shivam4567412/sic-mosfet-gate-driver/docs/internshipreport.pdf

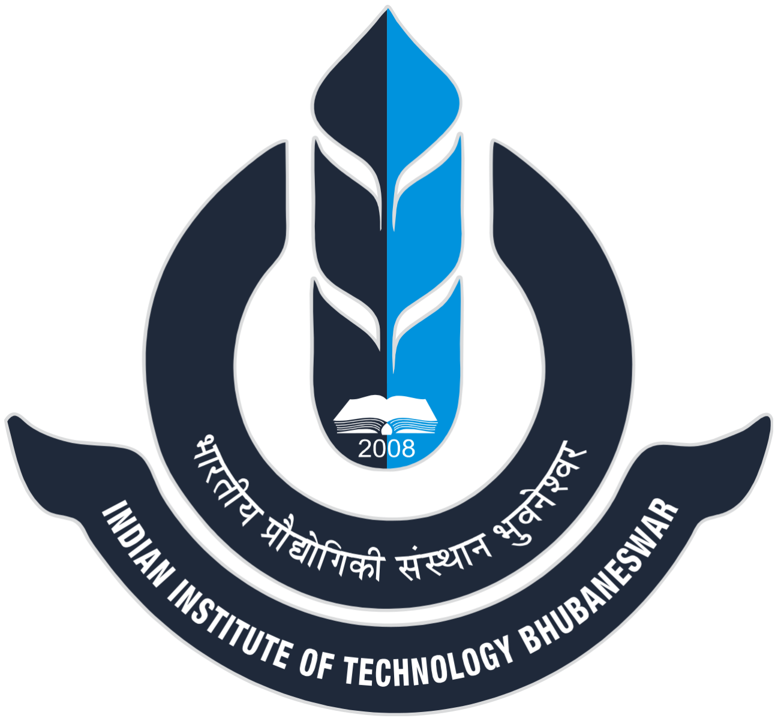
[picture p1: figure]

## Department Of Electrical Engineering

# Summer Internship Report

Name of Intern – Shivam Maurya

Institute – IIT Bhilai

Mentor – Dr. Olive Ray

Duration of internship – 4 Weeks (14 May 2026 to 10 June 2026)

## Design, Simulation, and Experimental Characterization of a SiC MOSFET Gate Driver System

## Time Line of Tasks –

- 14 May: Joining
- 14 May – 16 May: Altium Installation and BaSICs
- 16 May – 19 May: Made the schematic of STGAP2SICSNC isolated 4 A single gate driver using the Datasheet.
- 19May- 25May: Learned the PCB baSICs and then Designed a two-layer PCB for the same schematic in Altium. Also, made the BJT part of circuit of Murata power supply for analysis in LT spice. Concluded its working as an emitter follower.
- 25May – 26May: learned about Gerber files and how to export the PCB design for fabrication.
- 26May – 28May: Simulated the Gate driver circuit on LT spice and got the switching node waveform as expected.
- 28May – 31May: Learned about code composer studio and the microcontroller TMS320F28379D’s programming logic.
- 1June – 8June: Made the code for continuous pulse signal with deadband and used it first for checking the gate driver board, then performed the pulse test and captured the switching waveform and calculated the switching loss which were verified from the oscilloscope readings.
- 8June – 10June: Applied complementary signals at both the switches to capture the complementary switching waveform and also developed the code of double pulse.

## Introduction

This report presents the work carried out during a four-week summer internship at the Department of Electrical Engineering, IIT Bhubaneswar, from 14 May 2026 to 10 June 2026, under the guidance of Dr. Olive Ray. The internship focused on the design, simulation, and experimental characterization of power electronics circuits, with a specific emphasis on Silicon Carbide (SiC) MOSFET-based gate driver systems.

Wide Bandgap (WBG) semiconductor devices such as SiC MOSFETs have emerged as a preferred choice in modern power conversion systems owing to their superior switching speed, higher breakdown voltage, and lower conduction losses compared to conventional silicon devices. However, their fast-switching characteristics also introduce challenges such as parasitic ringing and precise gate drive requirements, making their experimental characterization an important area of study.

The internship covered a broad range of practical tasks: schematic design and PCB layout of an isolated gate driver circuit using the STGAP2SICSNC gate driver IC in Altium Designer, circuit simulation in LTspice, embedded firmware development for the TMS320F28379D C2000 microcontroller using Code Composer Studio (CCS), and hardware testing including continuous pulse generation, deadband signal verification, and the Double Pulse Test (DPT) for switching loss characterization of SCT35N65 SIC MOSFETs. Switching energies were measured using the Yokogawa DLM3054 oscilloscope.

This report documents the timeline of tasks, the technical methodology followed, key experimental results, and the challenges encountered along with how they were resolved.

## Brief Summary of Each Task

1 - Altium Designer – Schematic & PCB Basics

During the initial phase, I learned Altium Designer, a professional PCB design software widely used in the industry. I learned how to source and add components from online libraries such as Ultra Librarian and Element14, ensuring the correct symbols and footprints were imported. I also understood the importance of verifying component footprints against actual fabrication constraints to avoid design errors during manufacturing. Additionally, I gained familiarity with various passive and active components used in PCB design, including connectors, headers, test points, jumpers, and other standard circuit elements.

The following figure is from the data sheet of the gate driver

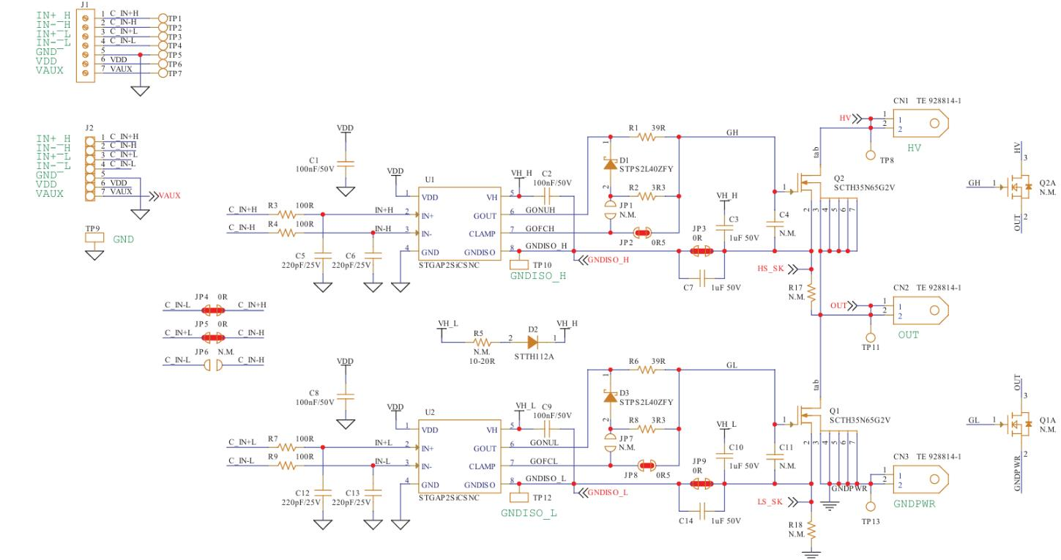
[picture p2: figure]
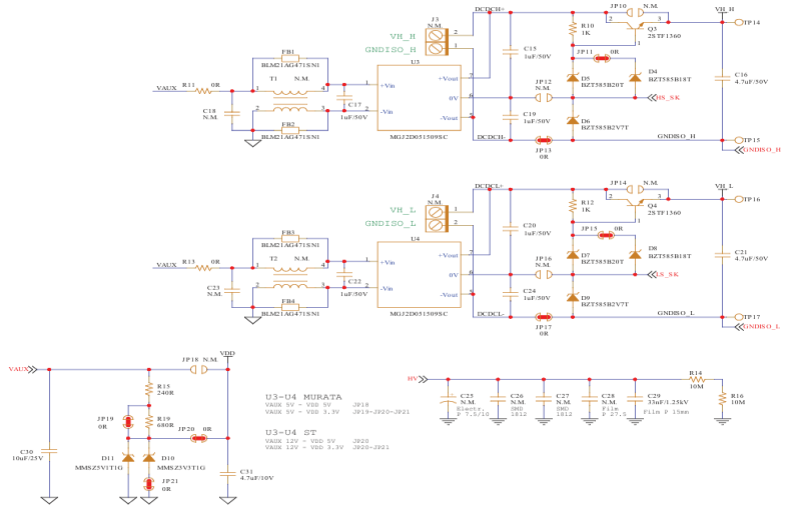
[picture p3: figure]
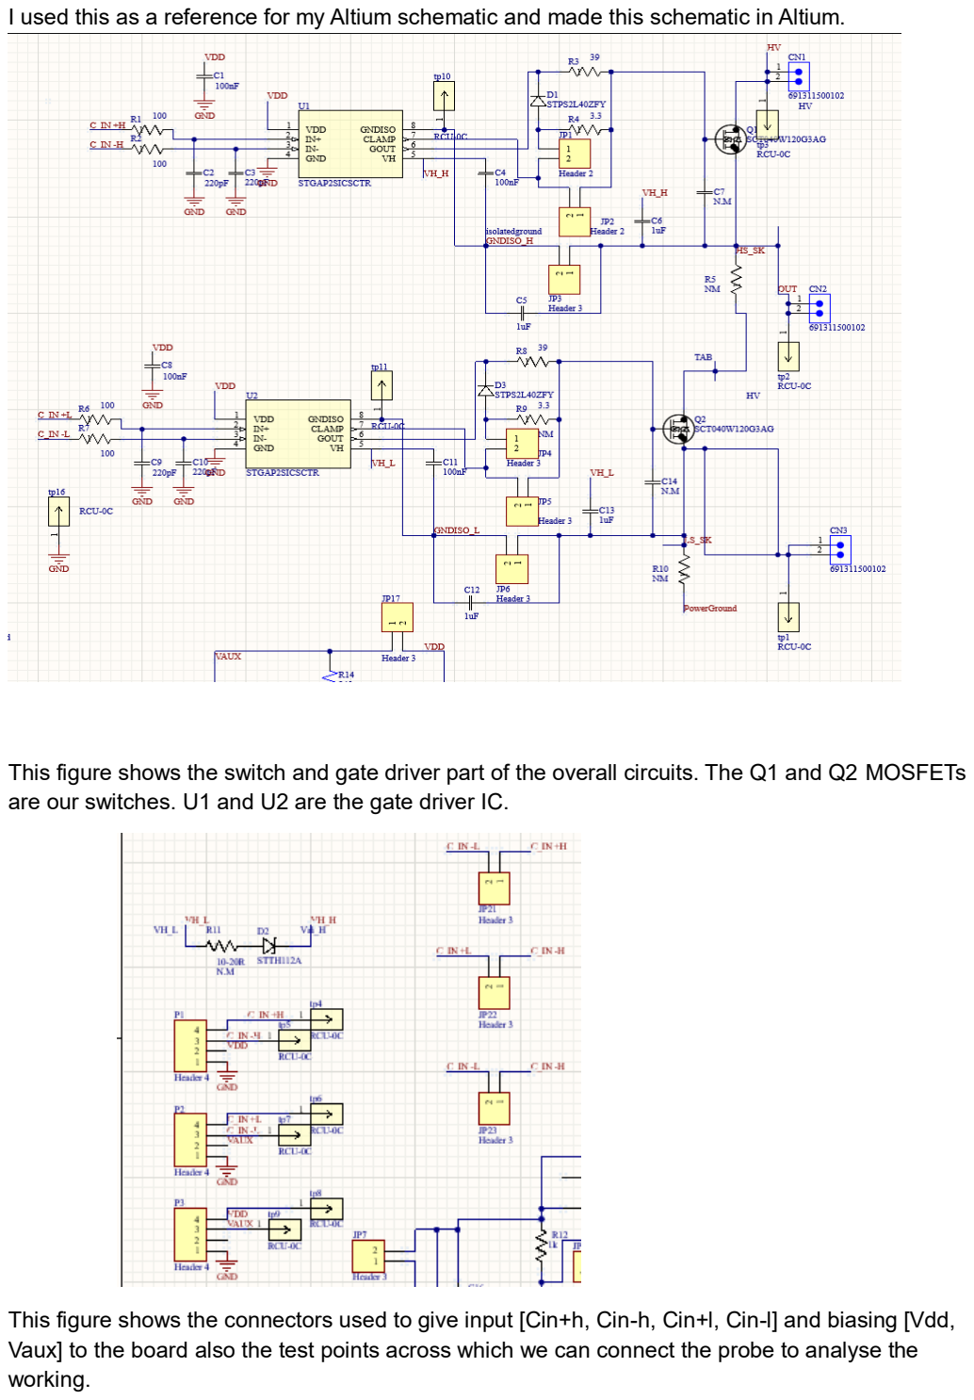
[picture p4: page 5]

I used this as a reference for my Altium schematic and made this schematic in Altium.

This figure shows the switch and gate driver part of the overall circuits. The Q1 and Q2 MOSFETs are our switches. U1 and U2 are the gate driver IC.

This figure shows the connectors used to give input [Cin+h, Cin-h, Cin+l, Cin-l] and biasing [Vdd, Vaux] to the board also the test points across which we can connect the probe to analyse the working.

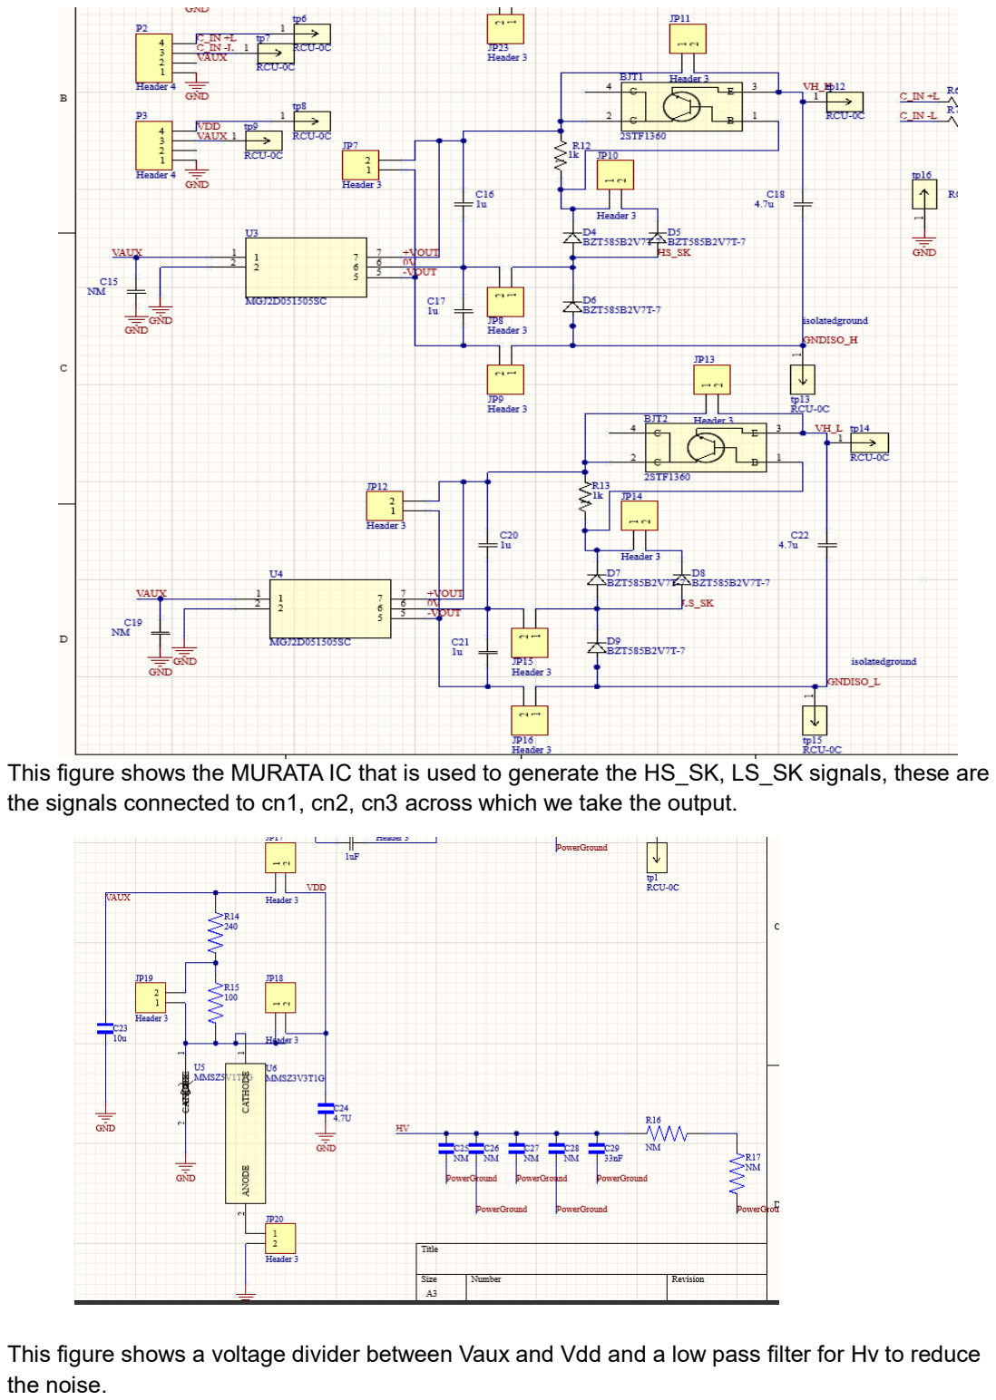
[picture p5: page 6]

This figure shows the MURATA IC that is used to generate the HS_SK, LS_SK signals, these are the signals connected to cn1, cn2, cn3 across which we take the output.

This figure shows a voltage divider between Vaux and Vdd and a low pass filter for Hv to reduce the noise.

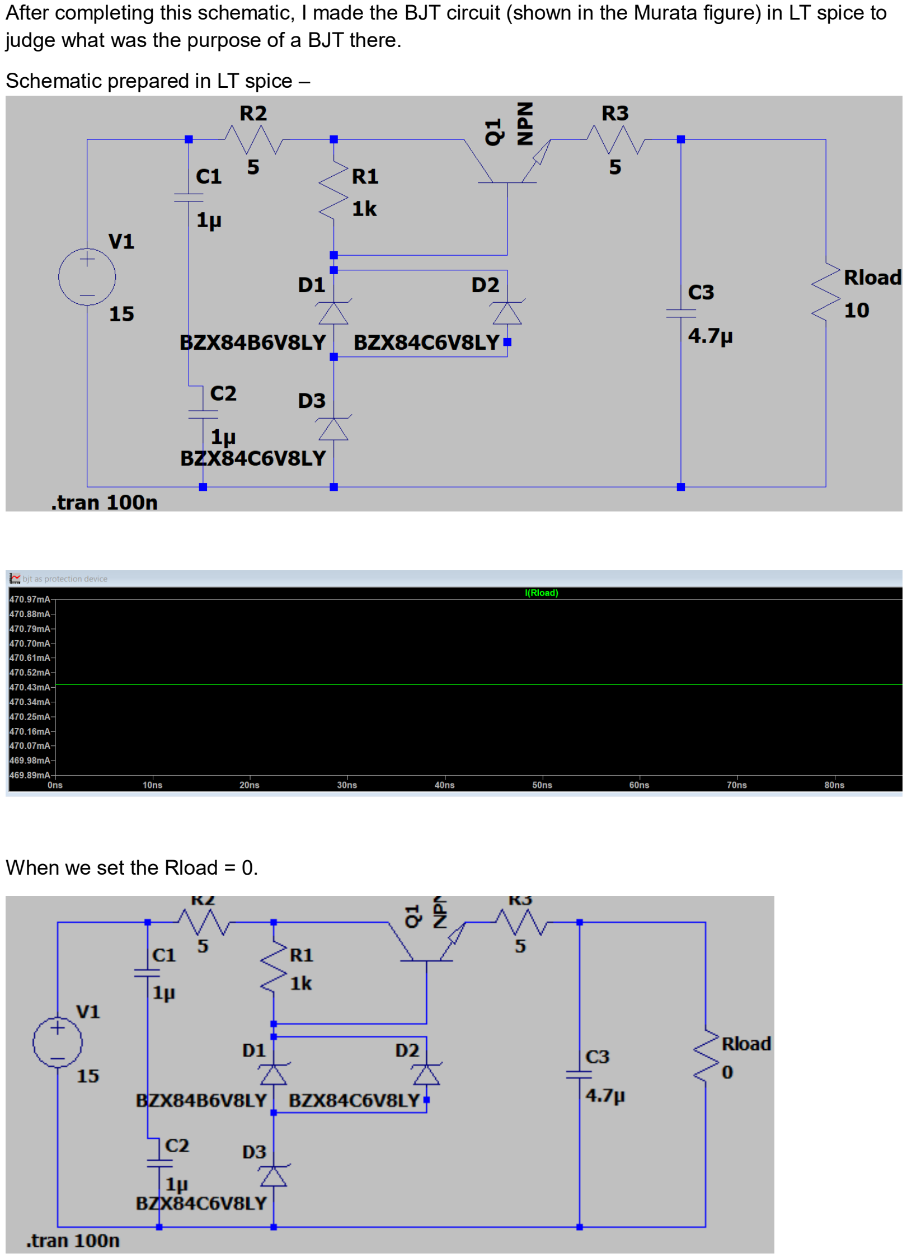
[picture p6: page 7]

After completing this schematic, I made the BJT circuit (shown in the Murata figure) in LT spice to judge what was the purpose of a BJT there.

Schematic prepared in LT spice –

When we set the Rload = 0.

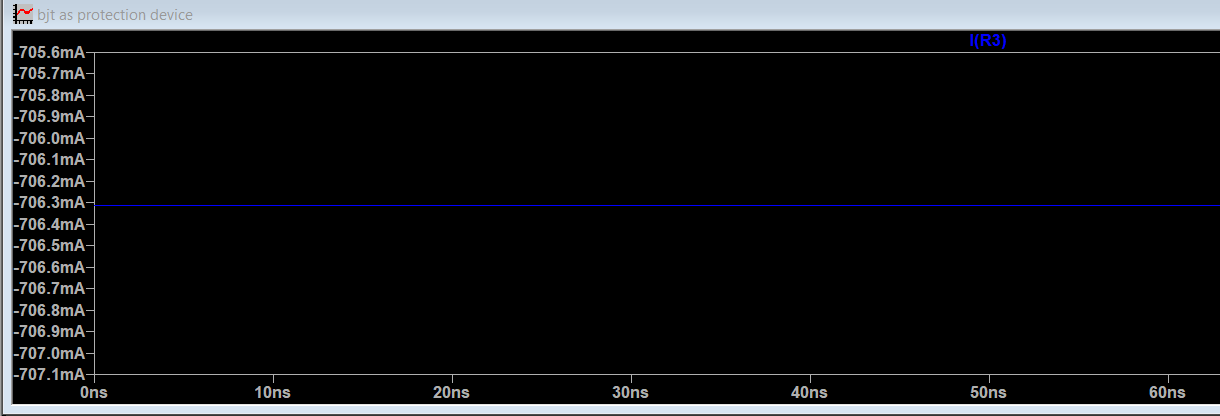
[picture p7: figure]

So, the current value remains almost constant when Rload is varied.

The emitter follower provides current gain and buffering while maintaining approximately unity voltage gain.

After completing the schematic and analysis, I proceeded to design the PCB layout for the gate driver circuit in Altium Designer. This phase gave me hands-on experience with the practical considerations and design rules that govern a good PCB layout. The key concepts I learned and applied are as follows:

- Component Placement: Kept input resistors and capacitors as close as possible to the gate driver IC to minimize parasitic inductance, which is critical in high-speed switching circuits to avoid unwanted voltage spikes and signal distortion.
- Edge Placement of Connectors: Positioned all output connectors along the edges of the board to ensure better airflow and thermal management, as well as easier access during testing and integration.
- Symmetrical Layout: Maintained board symmetry wherever possible to ensure uniform current distribution, reduce electromagnetic interference (EMI), and simplify the fabrication and assembly process.
- Input Header Accessibility: Placed all input headers (J1, J2) along the board edges so that they are easily accessible on the phySICal board during testing, debugging, and wiring.
- Two-Layer PCB: Designed the board as a two-layer PCB, utilizing the top layer for signal routing and the bottom layer for voltage divider, which helps in noise reduction and signal integrity.
- Design Rule Check (DRC): Ran DRC checks in Altium to verify that all clearances, trace widths, and via sizes met the fabrication constraints before finalizing the design.
- Gerber File Export: Learned how to generate and export Gerber files from Altium, which are the standard files sent to PCB manufacturers for fabrication.
- Importance of cross section area of wires according to the amount of current they are carrying.

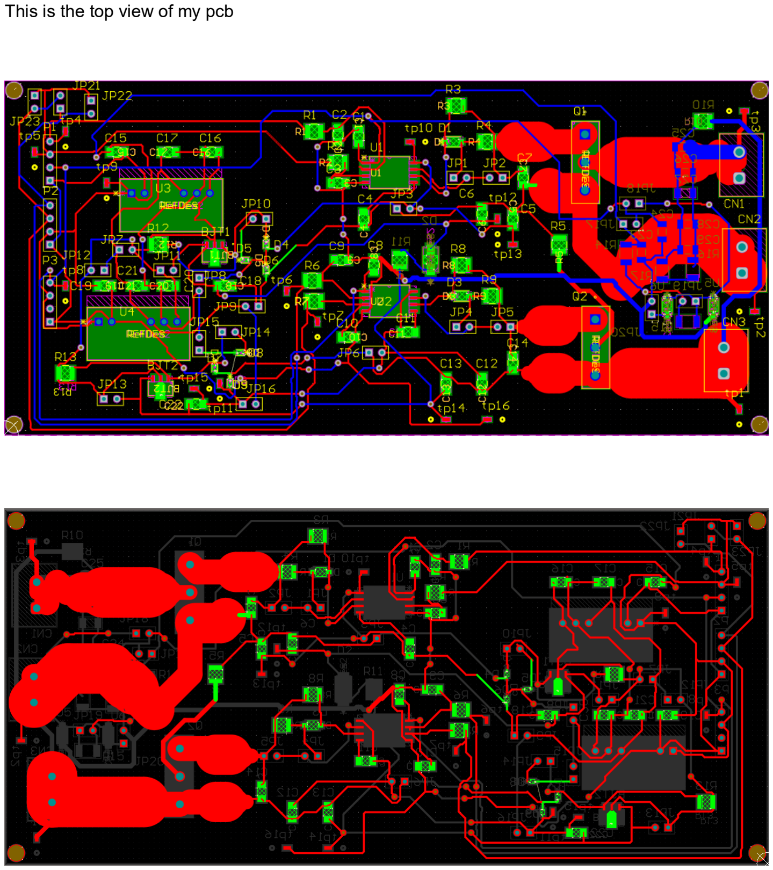
[picture p8: page 9]

This is the top view of my pcb

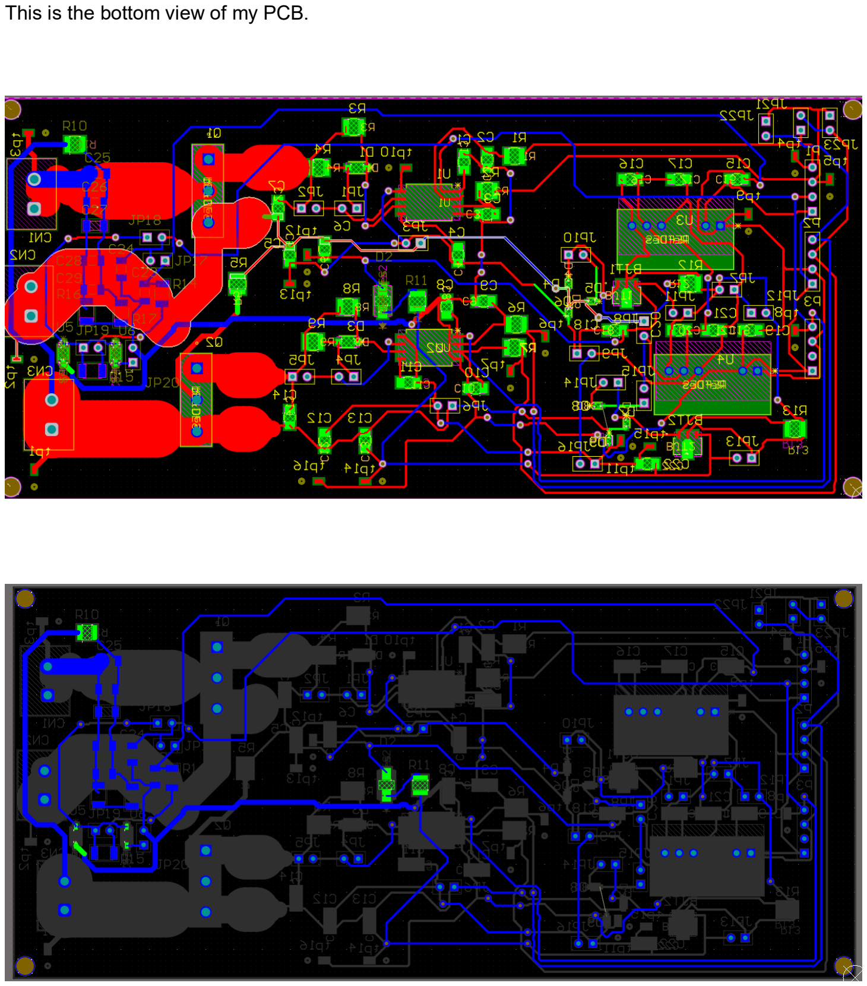
[picture p9: page 10]

This is the bottom view of my PCB.

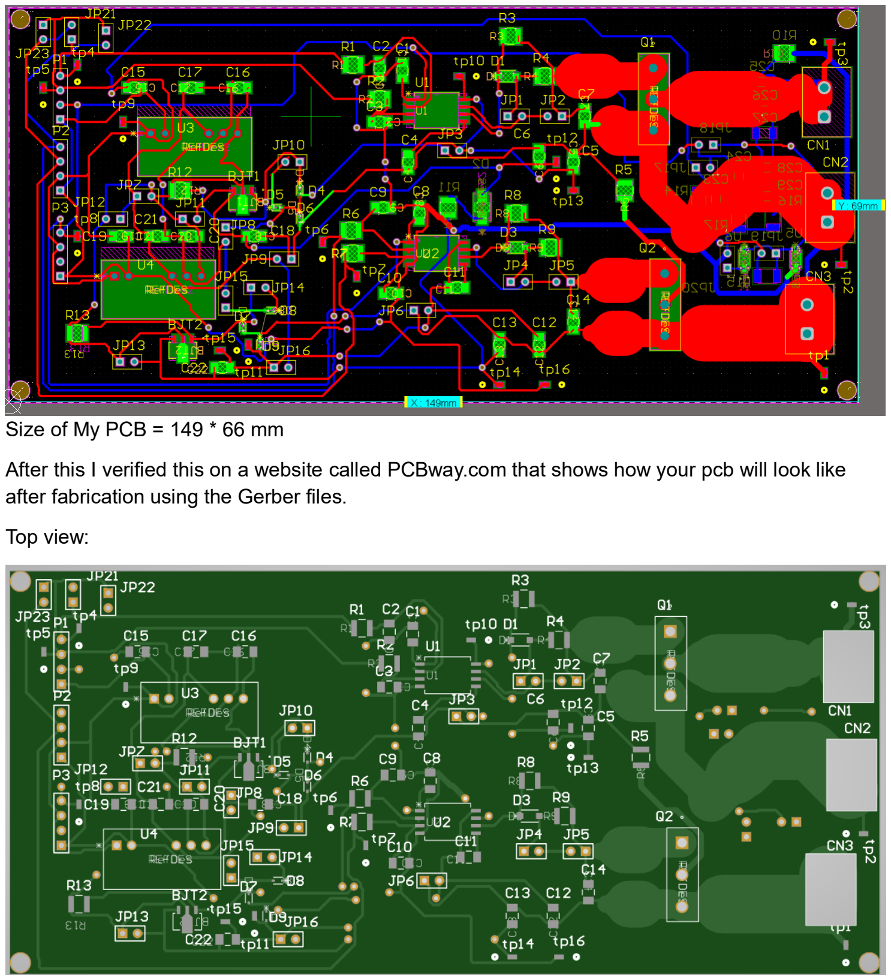
[picture p10: page 11]

Size of My PCB = 149 * 66 mm

After this I verified this on a website called PCBway.com that shows how your pcb will look like after fabrication using the Gerber files.

Top view:

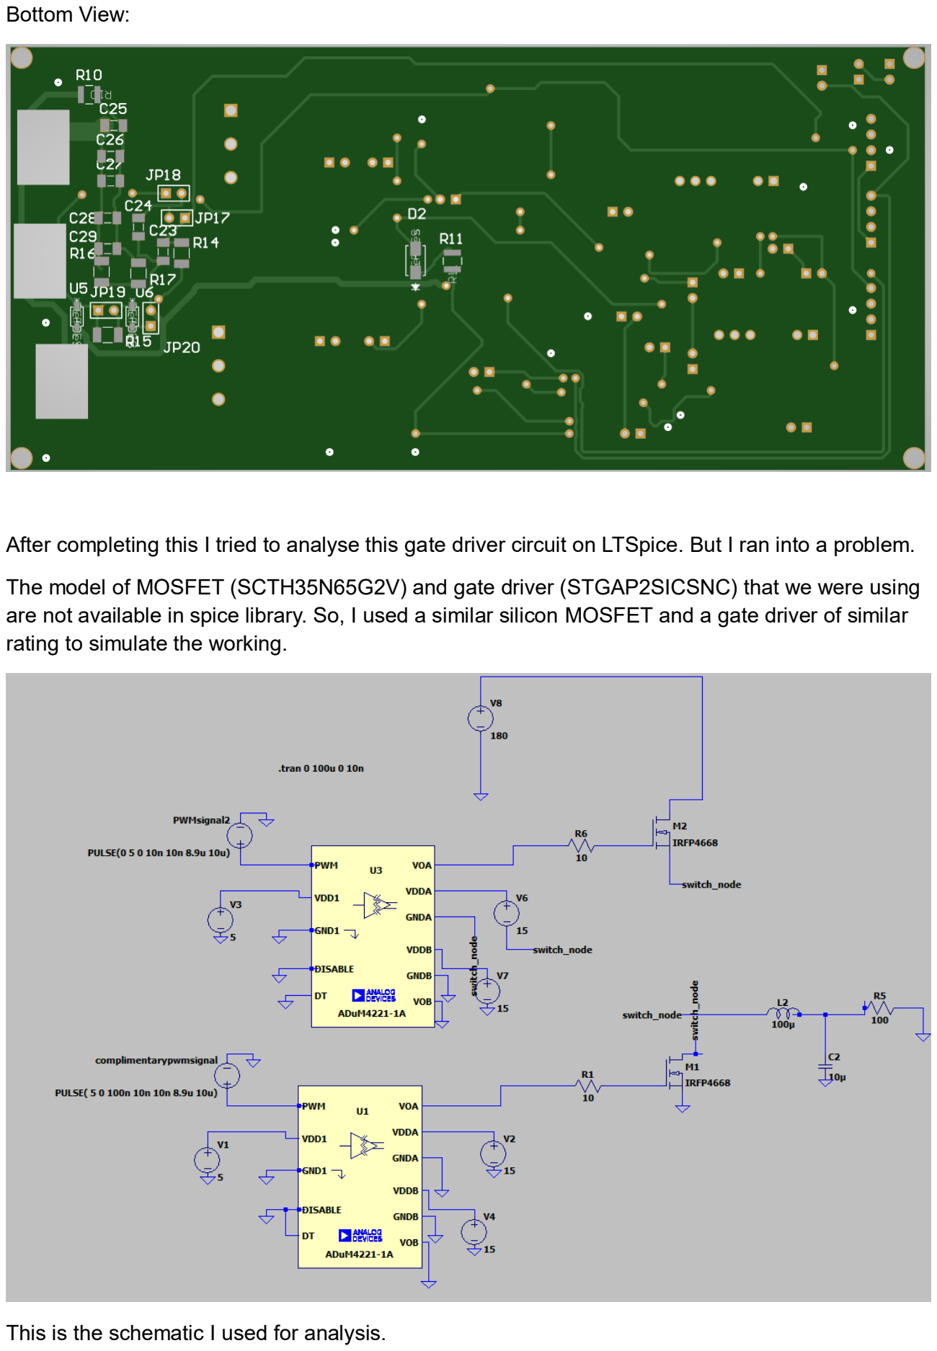
[picture p11: page 12]

Bottom View:

After completing this I tried to analyse this gate driver circuit on LTSpice. But I ran into a problem.

The model of MOSFET (SCTH35N65G2V) and gate driver (STGAP2SICSNC) that we were using are not available in spice library. So, I used a similar silicon MOSFET and a gate driver of similar rating to simulate the working.

This is the schematic I used for analysis.

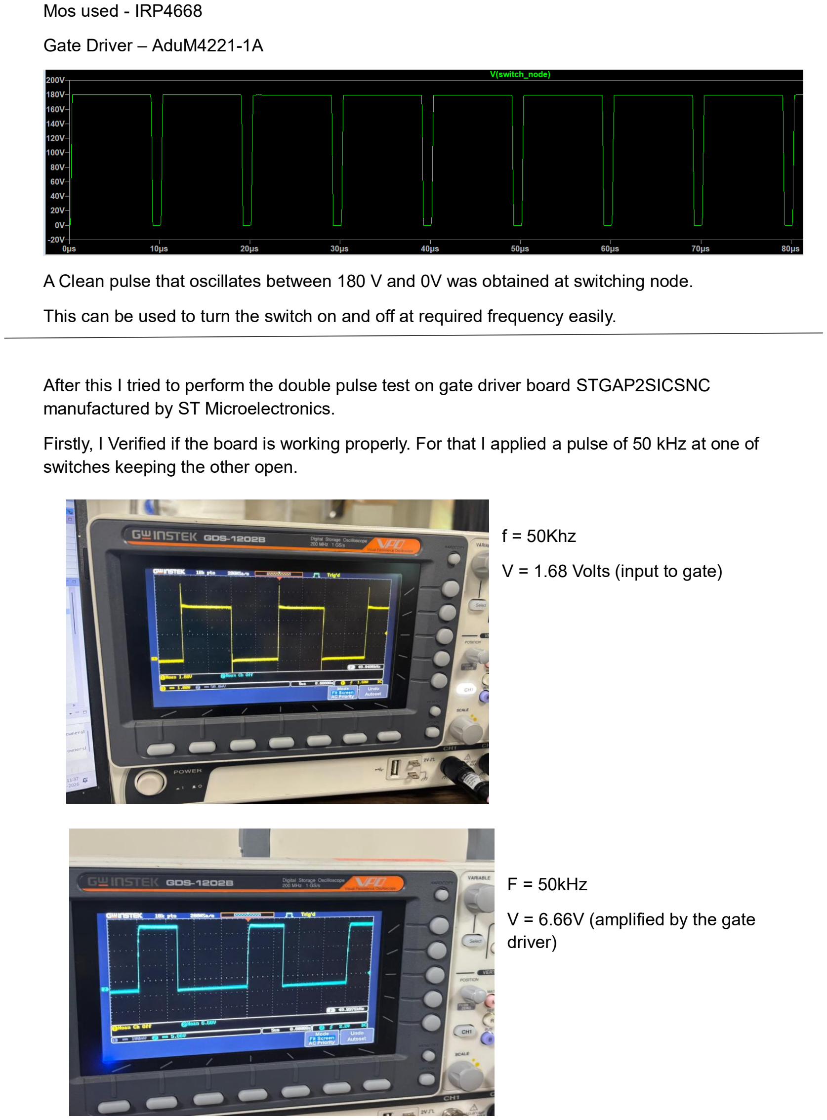
[picture p12: page 13]

Mos used - IRP4668

Gate Driver – AduM4221-1A

A Clean pulse that oscillates between 180 V and 0V was obtained at switching node.

This can be used to turn the switch on and off at required frequency easily.

After this I tried to perform the double pulse test on gate driver board STGAP2SICSNC manufactured by ST Microelectronics.

Firstly, I Verified if the board is working properly. For that I applied a pulse of 50 kHz at one of switches keeping the other open.

f = 50Khz

V = 1.68 Volts (input to gate)

F = 50kHz

V = 6.66V (amplified by the gate driver)

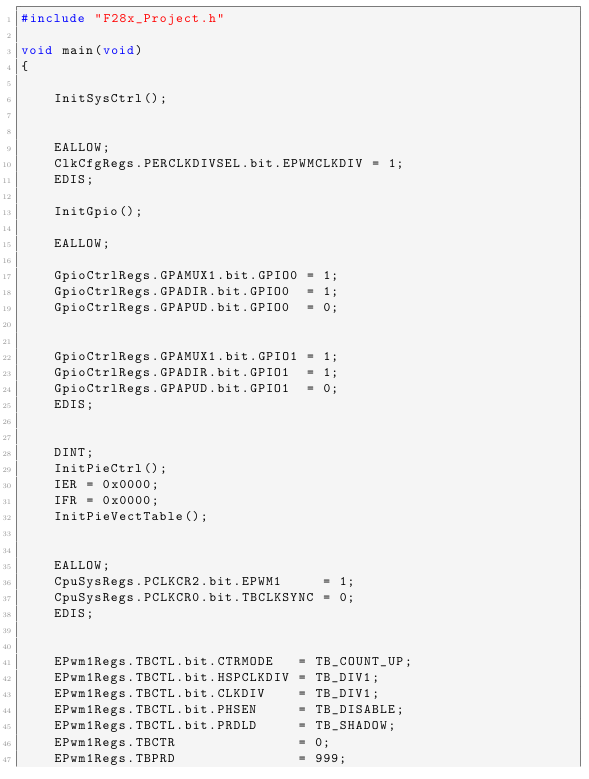
[picture p13: page 14]

I tested like this on various frequencies like 100kHz, 120kHz, etc. and got similar amplification.

Code used for this

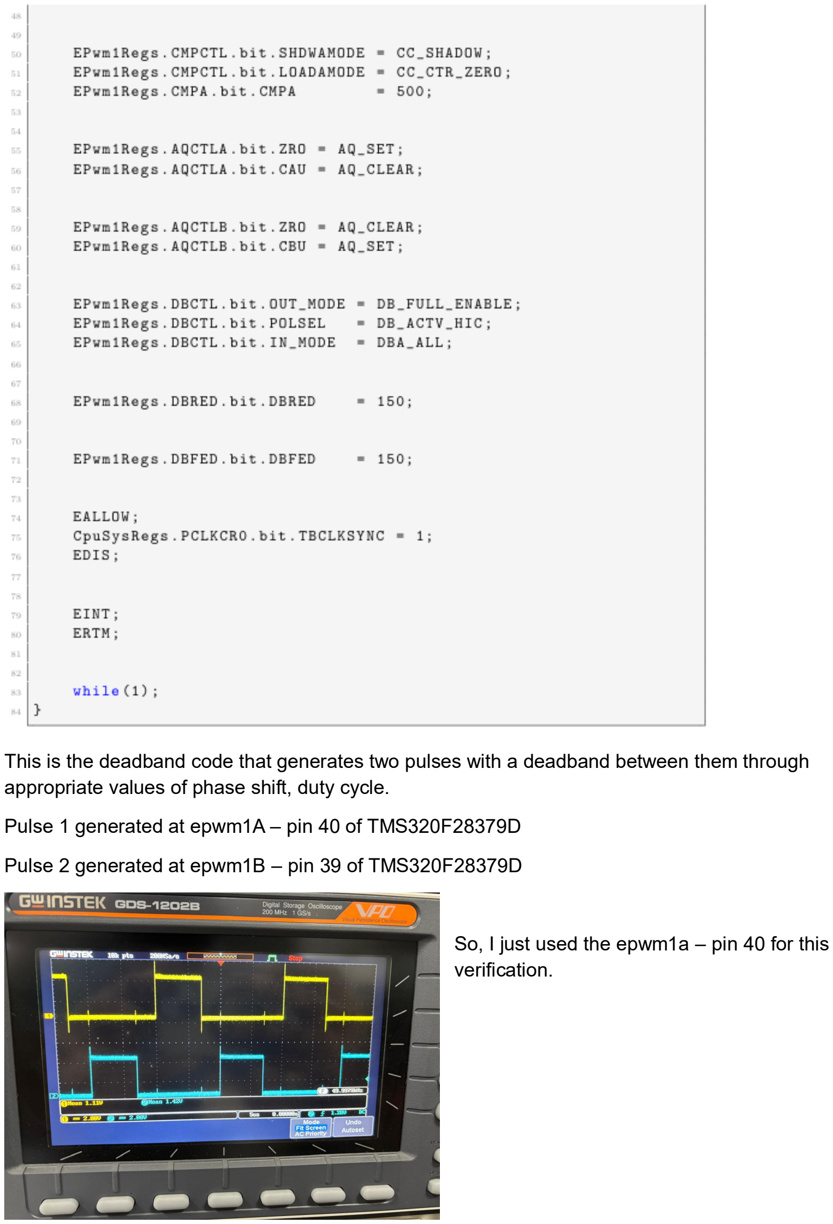
[picture p14: page 15]

This is the deadband code that generates two pulses with a deadband between them through appropriate values of phase shift, duty cycle.

Pulse 1 generated at epwm1A – pin 40 of TMS320F28379D

Pulse 2 generated at epwm1B – pin 39 of TMS320F28379D

So, I just used the epwm1a – pin 40 for this verification.

EPWMCLKDIV = 1 → EPWM clock = 100 MHz / 2 = 50 MHz (divides by 2)

TBPRD = 999 → 1000 counts per period

Period = 1000 × (1/50MHz) = 1000 × 20ns = 20 µs

Frequency = 1/20µs = 50 kHz

After this for generating the 100kHz pulse, set TBPRD = 500 and CMPA = 250

We know duty cycle = CMPA/ TBPRD *100

So, both the pulses have 50 % duty cycle.

Now, I tried to calculate the switching loss at different frequencies for the switches.

SETUP –

1- Used the lower switch q2. Kept upper switch q1 open.
2- Applied 50 kHz frequency pulse (continuous) and then increased the frequency in steps. 3- Took output voltage across the gate and source of q2 [cn2 and cn3], and output current as drain current.
4- Performed the calculation for switching loss by both hands and using the oscilloscope inbuilt maths function.

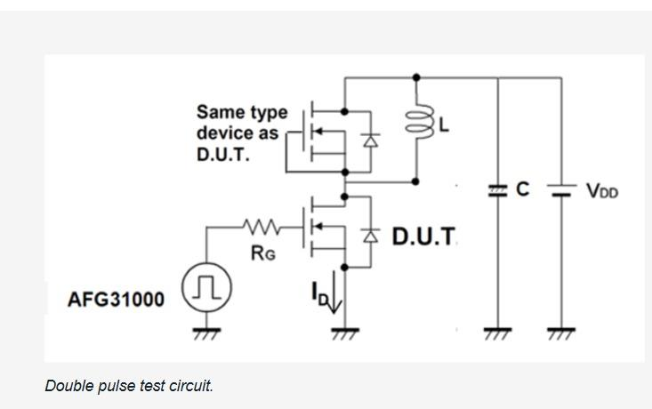
[picture p15: figure]

The value of inductor used – 100 uH.

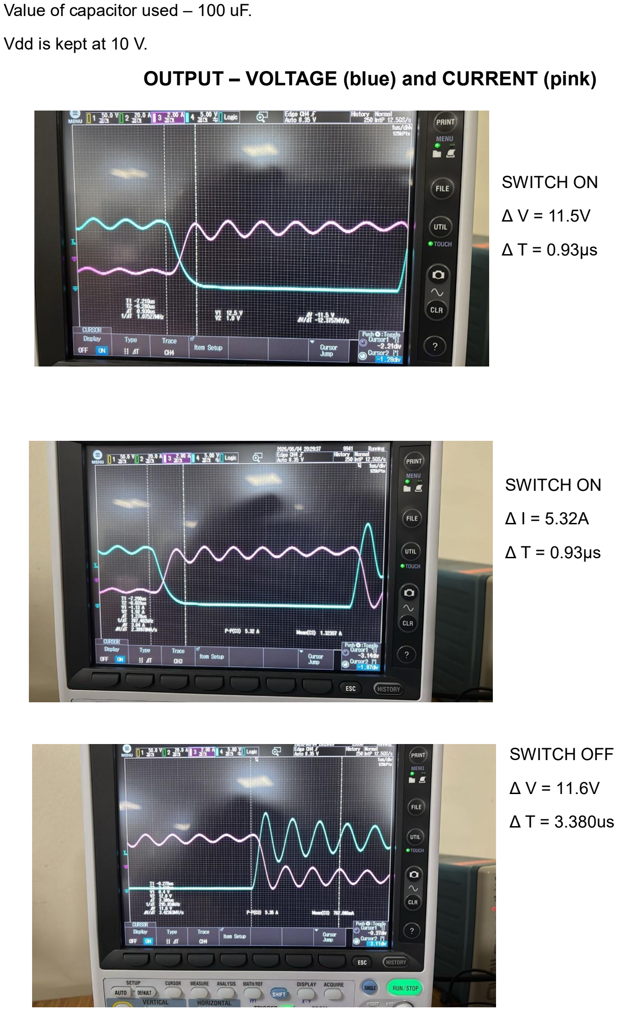
[picture p16: page 17]

Value of capacitor used – 100 uF.

Vdd is kept at 10 V.

OUTPUT – VOLTAGE (blue) and CURRENT (pink)

SWITCH ON

Δ V = 11.5V

Δ T = 0.93µs

SWITCH ON

Δ I = 5.32A

Δ T = 0.93µs

SWITCH OFF

Δ V = 11.6V

Δ T = 3.380us

SWITCH OFF

Δ I = 3.21A

Δ T = 3.380us

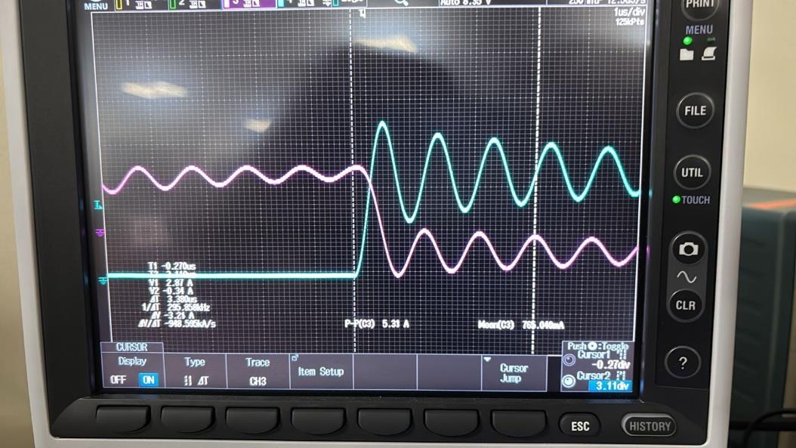
[picture p17: figure]

During switching on, Turn-On time ΔT = 0.93µs is defined as time from when Vds starts falling to when Vds reaches its final low value

Turn-Off time is defined as Time from when Vds starts rising to when Vds reaches Vbus

here ΔT = 3.38µs

Manual calculations (on next page)

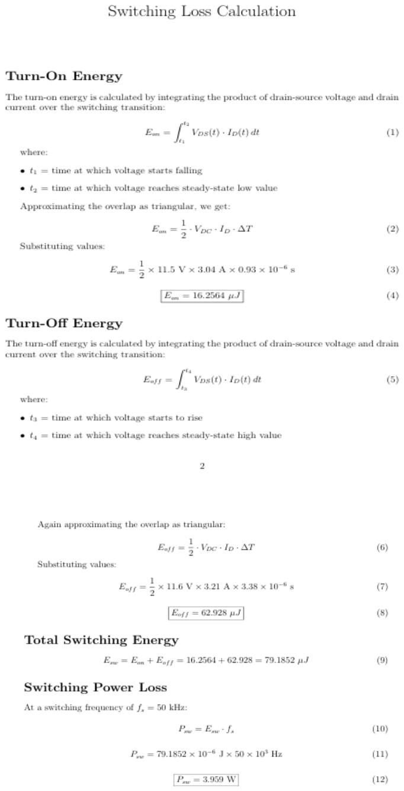
[picture p18: page 19]
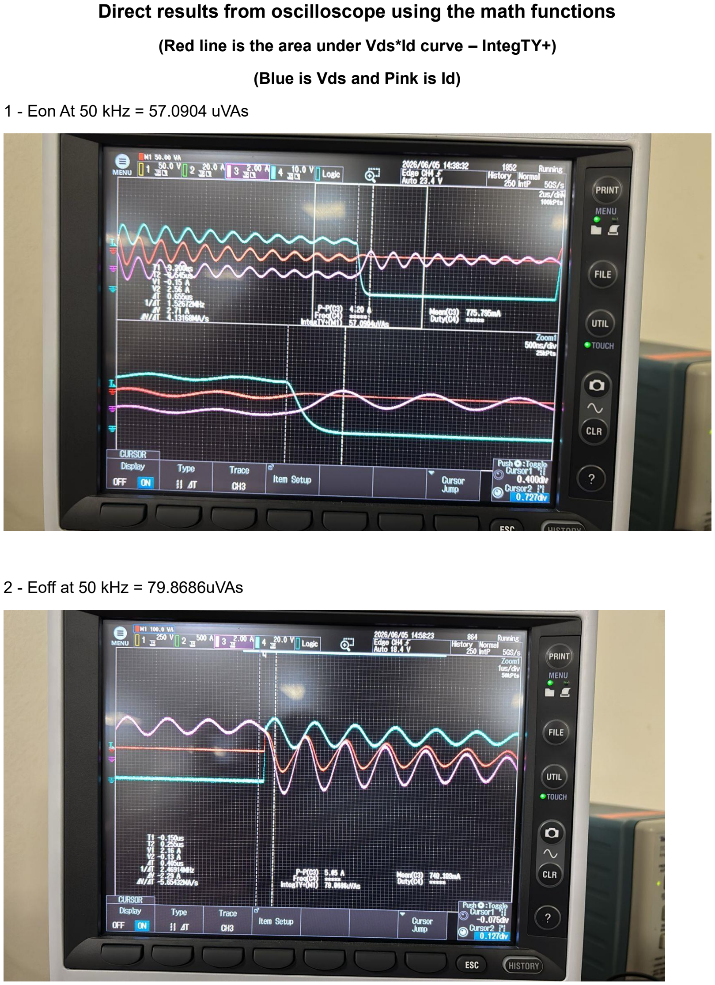
[picture p19: page 20]

Direct results from oscilloscope using the math functions

(Red line is the area under Vds*Id curve – IntegTY+)

(Blue is Vds and Pink is Id)

1 - Eon At 50 kHz = 57.0904 uVAs

2 - Eoff at 50 kHz = 79.8686uVAs

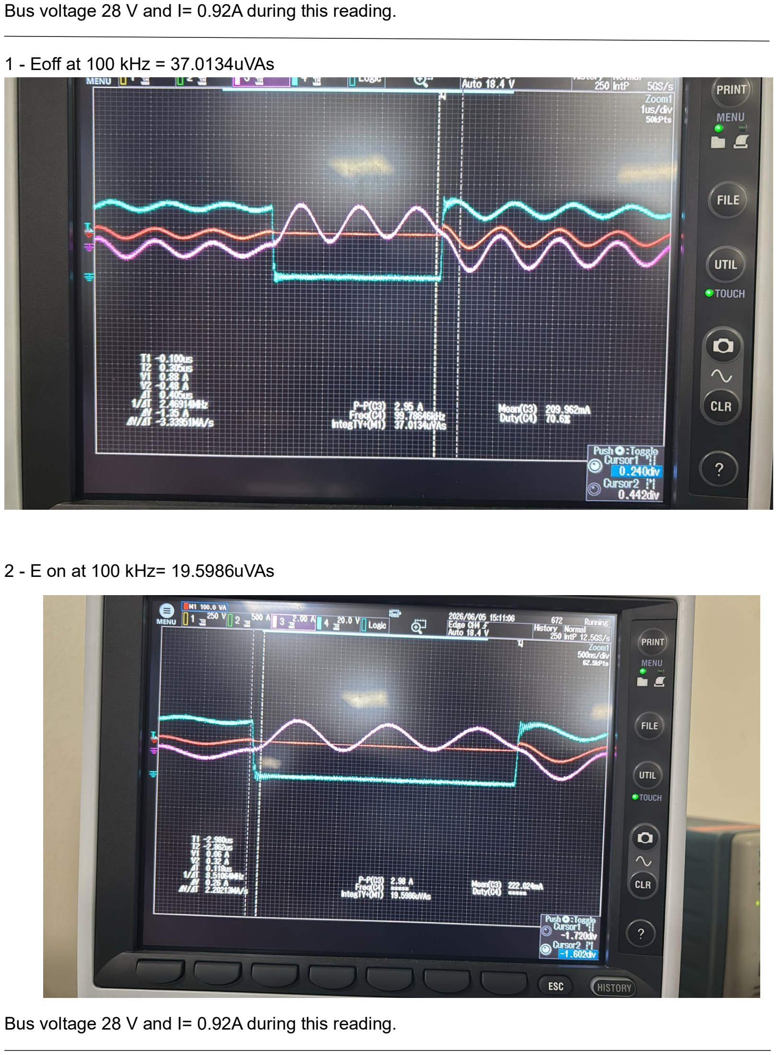
[picture p20: page 21]

Bus voltage 28 V and I= 0.92A during this reading.

1 - Eoff at 100 kHz = 37.0134uVAs

2 - E on at 100 kHz= 19.5986uVAs

Bus voltage 28 V and I= 0.92A during this reading.

For calculation of switching loss.

### Switching loss = (Eon+Eoff) * frequency

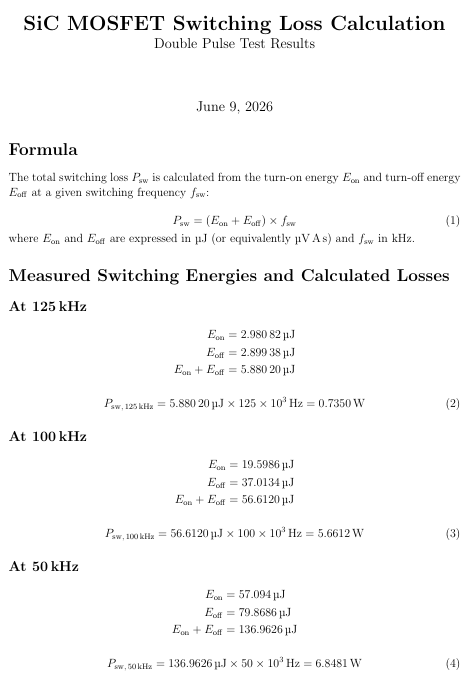
[picture p21: figure]

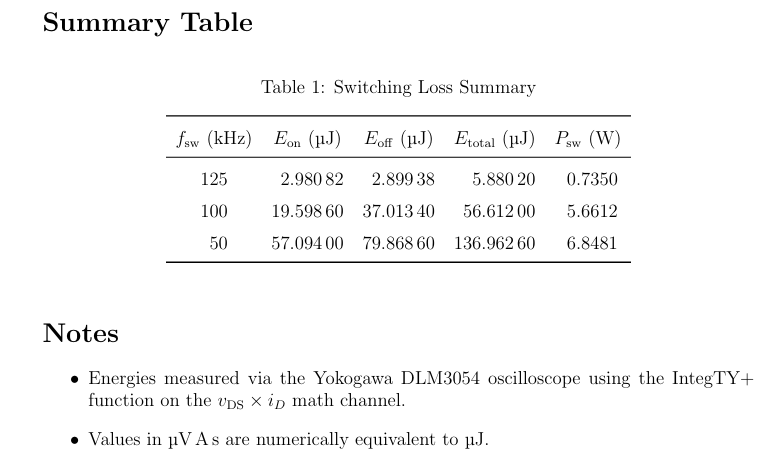
[picture p22: figure]

Problems I faced when testing for switching loss:

During the double pulse test, the measured drain-source voltage (V DS) and drain current (ID) waveforms exhibited significant oscillations following each switching transition, as observed on the Yokogawa
DLM3054 oscilloscope.

These oscillations, commonly referred to as ringing, arise due to the parasitic inductance present in the PCB traces and bus connections interacting with the output capacitance (C oss) of the SIC MOSFET to form a resonant LC tank circuit.

When the device switches, the rapid change in current (dI/dt) and voltage (dV/dt) injects energy into this parasitic LC network, causing it to oscillate at its natural resonant frequency.

The inherently fast switching speed of SIC MOSFETs, which is significantly higher than conventional silicon devices, results in larger dV/dt and dI/dt values and consequently more pronounced ringing.

While this behaviour is expected and does not indicate a fault in the circuit, it introduces complexity in the accurate determination of switching losses, as the oscillating VDS and ID waveforms deviate from the ideal triangular overlap assumed in manual calculations. The switching energy was therefore measured directly using the IntegTY+ function on the oscilloscope, which integrates the instantaneous power waveform (VDS × ID) over the switching interval to give a more accurate result than the triangular approximation.

Applying the Dead Band signal to Both the Switches simultaneously.

EPWM1a – Cin+h

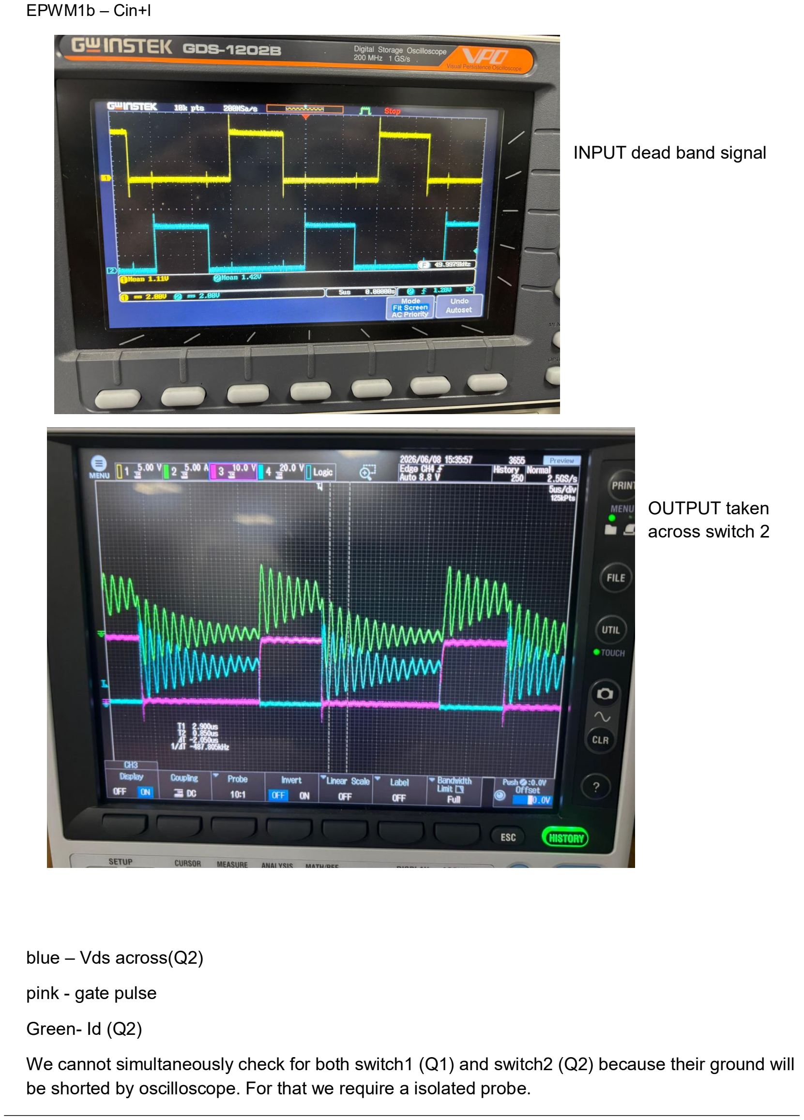
[picture p23: page 24]

EPWM1b – Cin+l

INPUT dead band signal

OUTPUT taken
across switch 2

blue – Vds across(Q2)

pink - gate pulse

Green- Id (Q2)

We cannot simultaneously check for both switch1 (Q1) and switch2 (Q2) because their ground will be shorted by oscilloscope. For that we require a isolated probe.

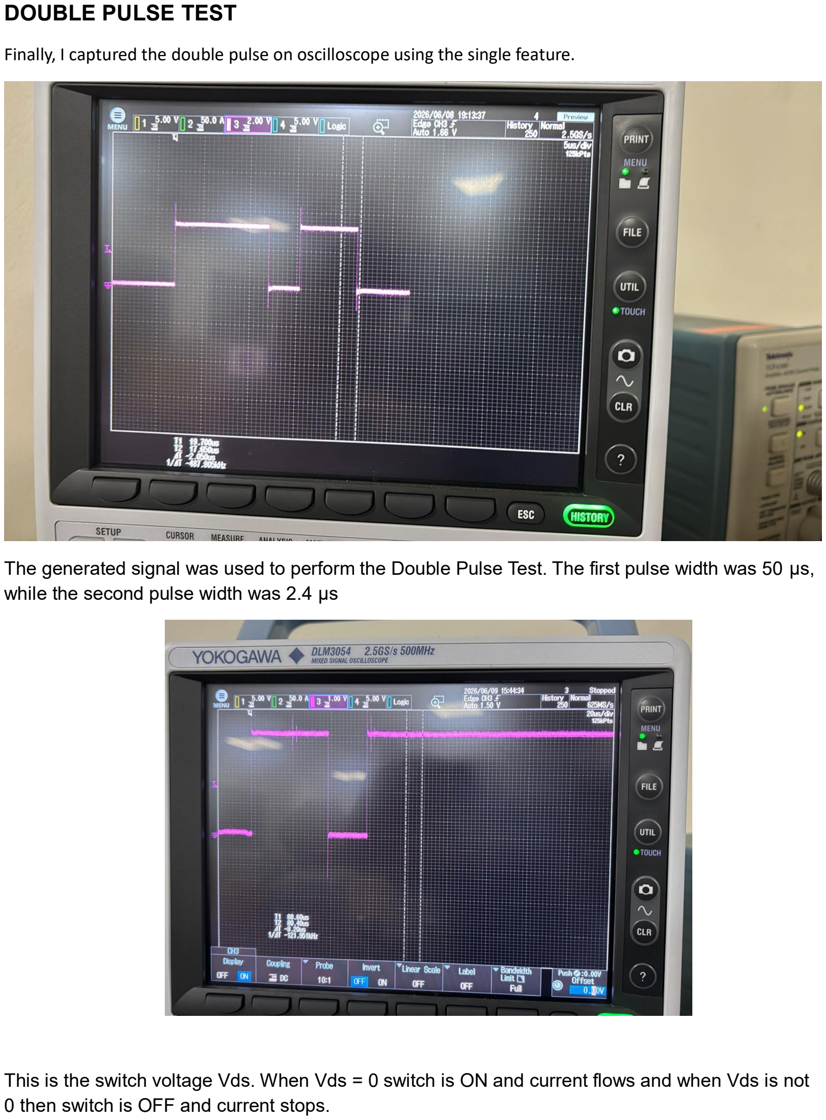
[picture p24: page 25]

DOUBLE PULSE TEST

Finally, I captured the double pulse on oscilloscope using the single feature.

The generated signal was used to perform the Double Pulse Test. The first pulse width was 50 μs, while the second pulse width was 2.4 μs

This is the switch voltage Vds. When Vds = 0 switch is ON and current flows and when Vds is not 0 then switch is OFF and current stops.

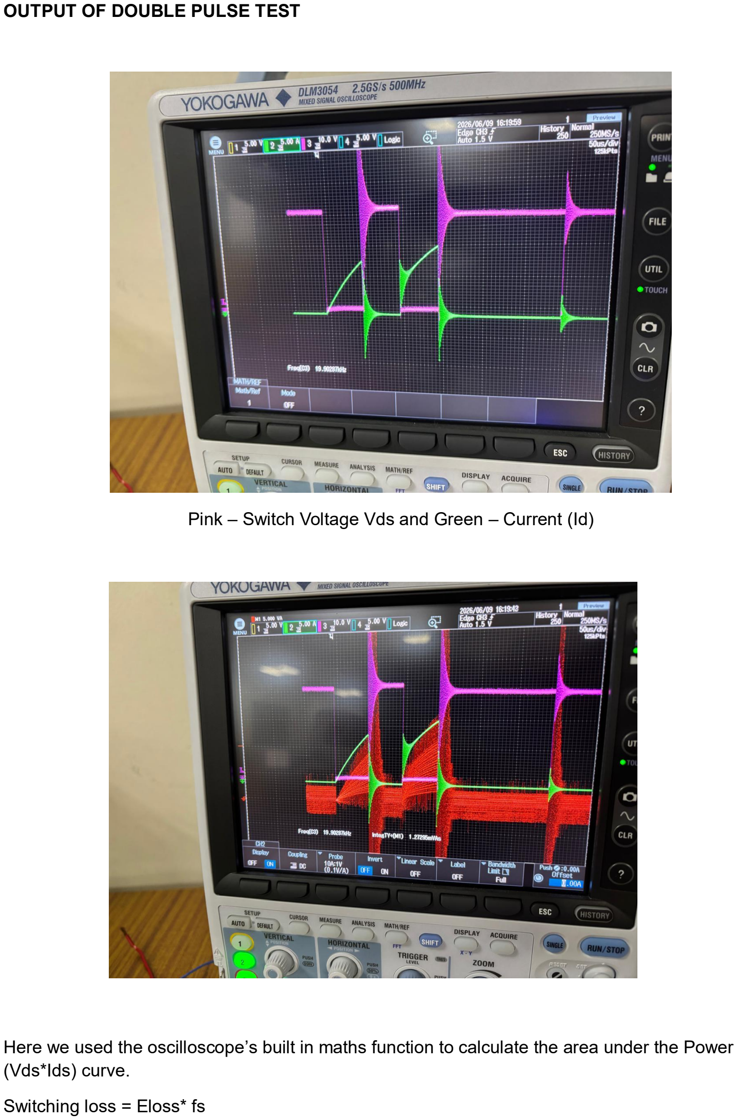
[picture p25: page 26]

OUTPUT OF DOUBLE PULSE TEST

Pink – Switch Voltage Vds and Green – Current (Id)

Here we used the oscilloscope’s built in maths function to calculate the area under the Power (Vds*Ids) curve.

Switching loss = Eloss* fs

Where fs is your intended converter switching frequency — whatever frequency your final design will operate at (e.g. 50 kHz, 100 kHz, 200 kHz).

For fs = 50kHz -> Switching loss = 6.36475W (voltage probe was set to 10x)

For fs = 100kHz -> Switching loss = 12.7295W

Code used for the double pulse generation

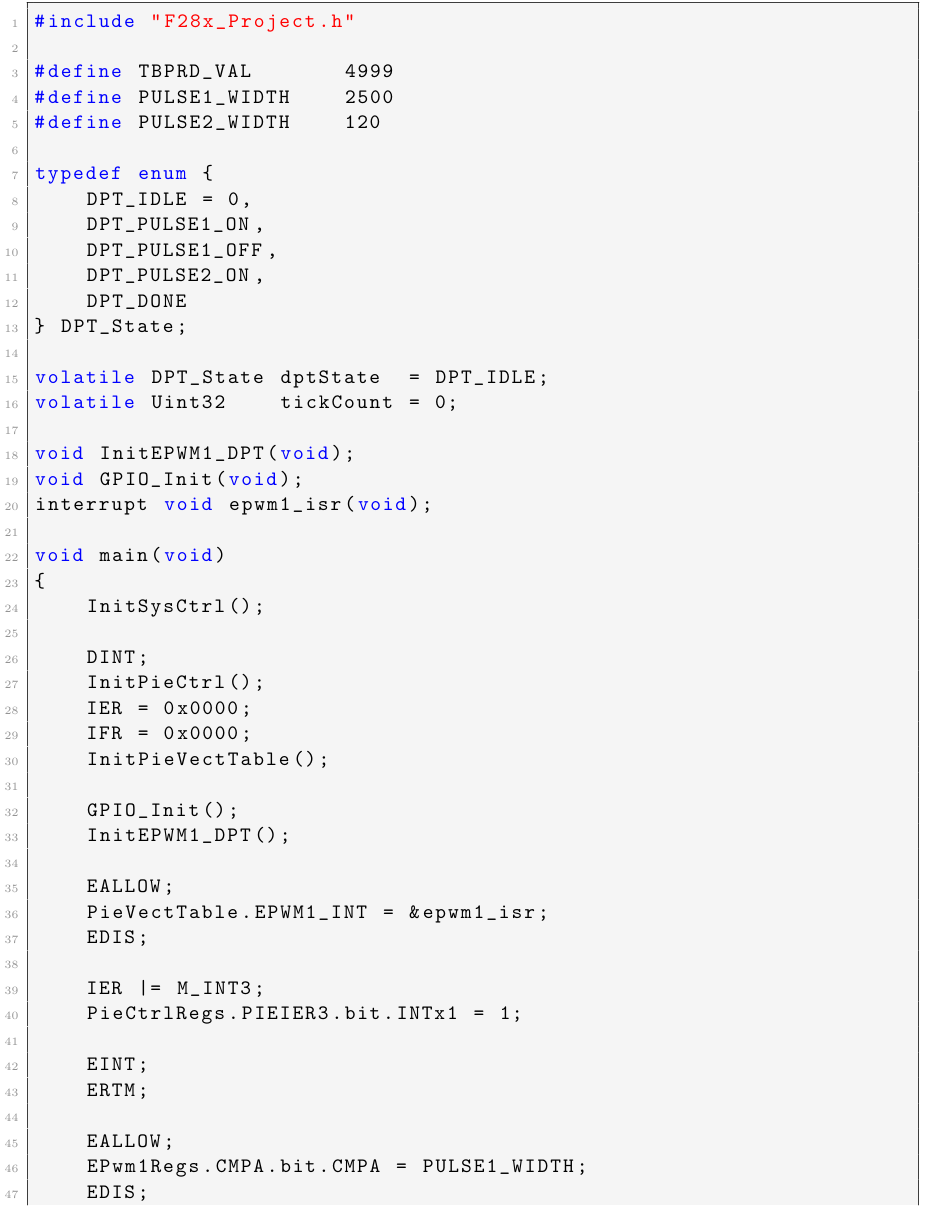
[picture p26: page 28]
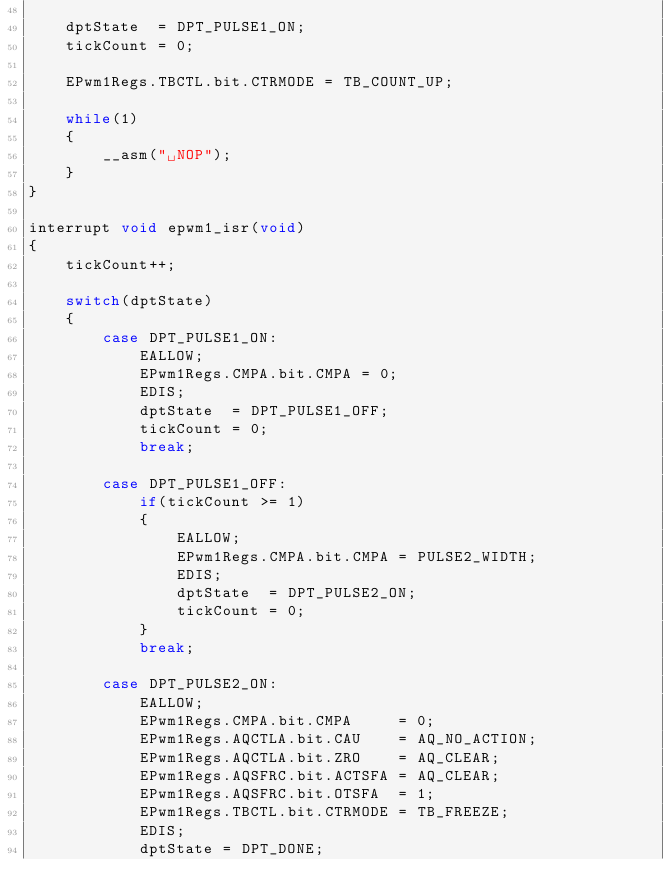
[picture p27: page 29]
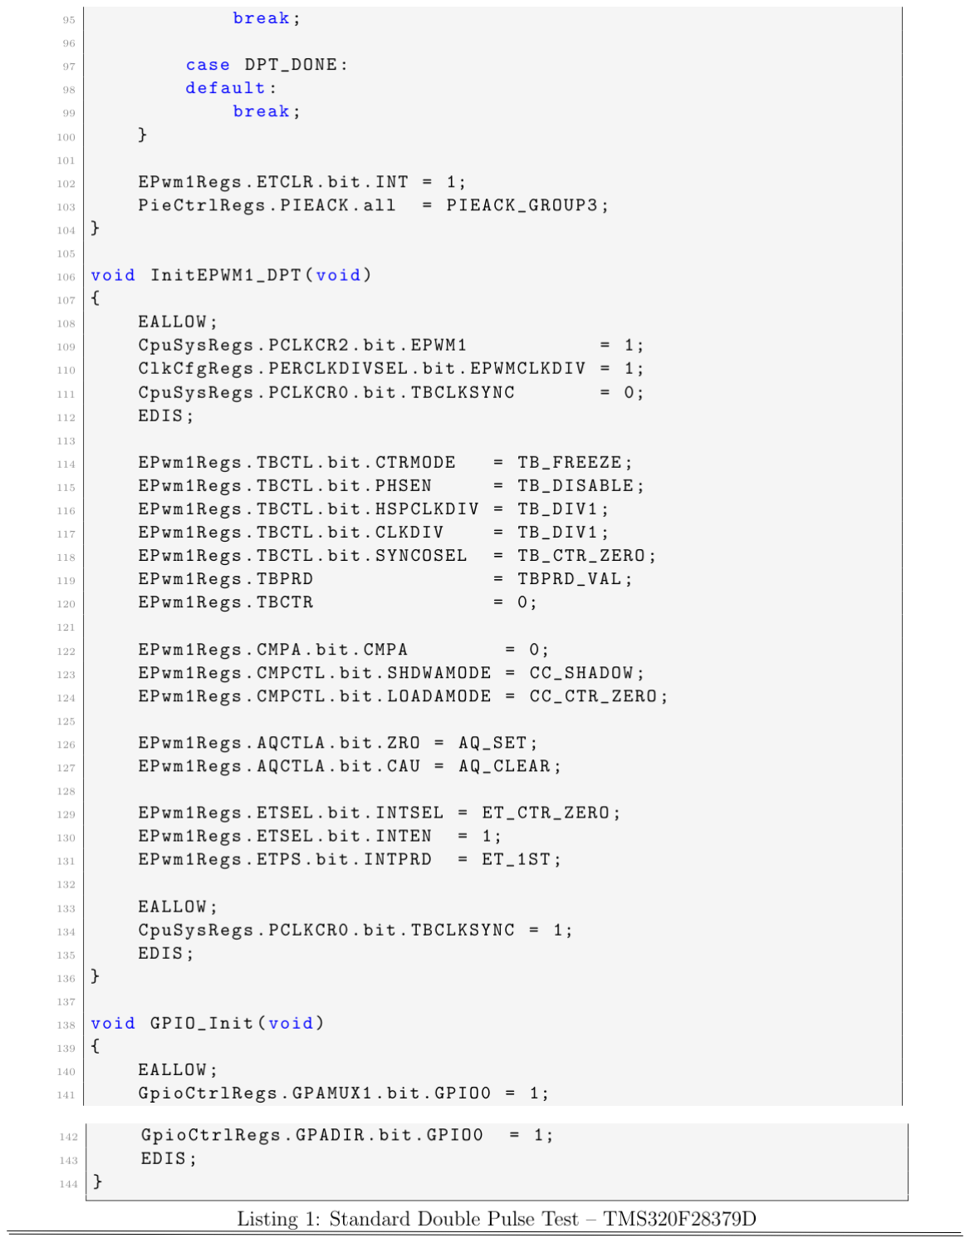
[picture p28: page 30]

Conclusion

This internship provided valuable hands-on experience in the design and characterization of a SIC MOSFET gate driver system, covering the complete workflow from schematic design and PCB development to hardware testing and switching loss measurement. The work helped bridge the gap between theoretical concepts learned in coursework and their practical implementation in power electronics.

Designing the PCB in Altium Designer highlighted the importance of component placement, trace routing, and design rule checks (DRC), especially for high-frequency switching applications. Although exact SPICE models for some components were unavailable, LTspice simulations were useful in understanding the expected switching behavior of the gate driver before hardware implementation.

Working with the TMS320F28379D C2000 microcontroller improved my understanding of control systems. I gained practical experience with ePWM configuration, including clock settings, frequency generation using TBPRD, duty cycle control through CMPA, and deadband insertion for complementary gate signals.

The Double Pulse Test was used to study the switching performance of the SCT35N65 SIC MOSFET. The measured switching energies were 57.09 μJ during turn-on and 79.87 μJ during turn-off at 50 kHz operation. The results showed the typical difference between turn-on and turn-off losses observed in SIC devices. Ringing observed after switching also demonstrated the effect of parasitic inductance and capacitance, emphasizing the importance of careful PCB layout in high-frequency power converters.

Overall, this internship provided exposure to the complete development cycle of a power electronics system—from design and simulation to microcontroller programming and experimental testing. The experience strengthened my technical knowledge and practical skills, and it has increased my interest in further research and applications involving wide bandgap devices, motor drives, and high-efficiency power converters.
