shivam4567412/sic-mosfet-gate-driver/lt spice simulation/bjt as protection device.asc

C1: cap; 1µ
C2: cap; 1µ
C3: cap; 4.7µ
D1: zener; BZX84B6V8LY
D2: zener; BZX84C6V8LY
D3: zener; BZX84C6V8LY
Q1: npn
R1: res; 1k
R2: res; 5
R3: res; 5
Rload: res; 0
V1: voltage; 15
.tran 100n
