shivam4567412/sic-mosfet-gate-driver/lt spice simulation/switch simulation.asc

C2: cap; 10µ
complimentarypwmsignal: voltage; PULSE( 5 0 100n 10n 10n 8.9u 10u)
L2: ind; 100µ
M1: nmos; IRFP4668
M2: nmos; IRFP4668
PWMsignal2: voltage; PULSE(0 5 0 10n 10n 8.9u 10u)
R1: res; 10
R5: res; 100
R6: res; 10
U1: ADuM4221-1A
U3: ADuM4221-1A
V1: voltage; 5
V2: voltage; 15
V3: voltage; 5
V4: voltage; 15
V6: voltage; 15
V7: voltage; 15
V8: voltage; 180
Named nets: 0, switch_node
.tran 0 100u 0 10n
