shivam4567412/sic-mosfet-gate-driver/(list of files, drawings)

Other design files:
pcb-design/finalpcbmaybe.PcbDoc
pcb-design/ram.SchDoc
