shivam4567412/sic-mosfet-gate-driver/firmware/epwm_deadband.c

#include "F28x_Project.h"

void main(void)
{
    InitSysCtrl();

    EALLOW;
    ClkCfgRegs.PERCLKDIVSEL.bit.EPWMCLKDIV = 1;
    EDIS;

    InitGpio();

    EALLOW;
    GpioCtrlRegs.GPAMUX1.bit.GPIO0 = 1;
    GpioCtrlRegs.GPADIR.bit.GPIO0 = 1;
    GpioCtrlRegs.GPAPUD.bit.GPIO0 = 0;

    GpioCtrlRegs.GPAMUX1.bit.GPIO1 = 1;
    GpioCtrlRegs.GPADIR.bit.GPIO1 = 1;
    GpioCtrlRegs.GPAPUD.bit.GPIO1 = 0;
    EDIS;

    DINT;
    InitPieCtrl();
    IER = 0x0000;
    IFR = 0x0000;
    InitPieVectTable();

    EALLOW;
    CpuSysRegs.PCLKCR2.bit.EPWM1 = 1;
    CpuSysRegs.PCLKCR0.bit.TBCLKSYNC = 0;
    EDIS;

    EPwm1Regs.TBCTL.bit.CTRMODE = TB_COUNT_UP;
    EPwm1Regs.TBCTL.bit.HSPCLKDIV = TB_DIV1;
    EPwm1Regs.TBCTL.bit.CLKDIV = TB_DIV1;
    EPwm1Regs.TBCTL.bit.PHSEN = TB_DISABLE;
    EPwm1Regs.TBCTL.bit.PRDLD = TB_SHADOW;
    EPwm1Regs.TBCTR = 0;
    EPwm1Regs.TBPRD = 999;

    EPwm1Regs.CMPCTL.bit.SHDWAMODE = CC_SHADOW;
    EPwm1Regs.CMPCTL.bit.LOADAMODE = CC_CTR_ZERO;
    EPwm1Regs.CMPA.bit.CMPA = 500;

    EPwm1Regs.AQCTLA.bit.ZRO = AQ_SET;
    EPwm1Regs.AQCTLA.bit.CAU = AQ_CLEAR;

    EPwm1Regs.AQCTLB.bit.ZRO = AQ_CLEAR;
    EPwm1Regs.AQCTLB.bit.CBU = AQ_SET;

    EPwm1Regs.DBCTL.bit.OUT_MODE = DB_FULL_ENABLE;
    EPwm1Regs.DBCTL.bit.POLSEL = DB_ACTV_HIC;
    EPwm1Regs.DBCTL.bit.IN_MODE = DBA_ALL;

    EPwm1Regs.DBRED.bit.DBRED = 150;
    EPwm1Regs.DBFED.bit.DBFED = 150;

    EALLOW;
    CpuSysRegs.PCLKCR0.bit.TBCLKSYNC = 1;
    EDIS;

    EINT;
    ERTM;

    while (1);
}
